mwezi2k8/JetSetGo-/README- jsg.md

# JetSetGO! - A RC high wing, bi-propellor trainer plane

Total time spent : 13+ hours



---

### JOURNAL #1 BUILDING MY FIRST RC AIRCRAFT!
Time spent : 1 hour 20 minutes

Deciding the basic design.
From a long time, I was fascinated by seeing rc trainers online, so I wanted to build one and I decided why not for expedition!
So I went off researching about different aircrafts for beginners, mostly YouTube and internet surfing
Since this was my first aircraft, the most beginner friendly one I found is a standard high wing rc trainer.
But I was not satisfied by that so after some more research and going through different innovative designs, I decided to build a bi-propellor.



This was my inspiration which I found on the internet.

---

### JOURNAL #2 Research and concept
Time spent : 1 hour for wings, 2 hours 15 minutes for tail, fuselage, nose) 3 hours 15 minutes

The concept is a twin-motor high-wing trainer, next was researching for wings, tails, fins e.t.c
After going through random YouTube videos and some websites, what I finalised was -

A. Wings- Armin folded wing with two counter-rotating motors in pods under the wing.



B. TAIL AND FINS - inspired from my childhood favourite V22 Osprey style H tail



C.NOSE - a square-pyramid nose, since there is no motor on the nose, a simple square pyramid nose does the job!

D.FUSELAGE - I was tired researching for wings, tail and nose so I decided to go on with a simple back tapered fuselage

---

### JOURNAL #3 Studying basics of aerodynamics
Time spent : 2 hour 10 minutes

While surfing through internet for finalising the designs and completing the concept, I realised that I can't randomly attach any part anywhere as I wish, everything needs to be planned to make it aerodynamically more efficient.
Carelessly if I make one side of the wing slightly heavy or shift the CG, the game is over!
This also sparked an interest in me which made me study basics of aerodynamics and making a rc trainer
I studied about 2 hours 10 minutes , which I will try my best to further summarise below so someone with zero experience in aviation could understand the basics and reciprocate, also from this point I will be directly using those terminology

3.1) forces on an airplane -



The negative forces are the drag and the weight, plane counters it by Thrust for Drag and lift for weight

3.2) Airfoil and lift generation-
How is the lift generated? Something special about the wings?

Airfoil -



The cross section of the wing and its peculiar shape is in order to generate lift
Aerodynamic characteristics vary greatly with airfoil shape

Lift generation-



Due to the peculiar shape of the airfoil, a curvature is induced in the incoming airflow. Due to the asymmetry in this curvature on the top and bottom parts of the wing, a net upward lift is generated.

Some more physics, the lift equation

L = Cl x (1/2 x ρ x v²) x A

L = lift (N), Cl = coefficient of lift, ρ = density (kg/m³), v = velocity (m/s), A = wing area (m²)

---

### JOURNAL #4 Anatomy of the plane
Time spent : 2 hours

4.1) The parts -



4.2) Aircraft principal axis -



So how the movement in each axes controlled?

~roll motion due to the movement of ailerons  
~Yaw motion due to the movement of rudder  
~pitch motion due to the movement of elevator

4.3) Centre of gravity-
The point at which the torque and force are balanced is the Centre of Gravity
It should lie either at or ahead of 1/4 of the chord length of the wing for neutral or positive stability, respectively.



High wing provides the roll stability!

4.4) Aspect ratio -



Higher AR → Better performance, better stability, but also leads to wing bending.

Lower AR → Great for structure, better maneuverability, but increases drag.

---

### Journal #5 Planning the power
Time spent : 45 minutes

Considering the parts I already had the electronics I finalised are as follows;
Two 1400 kV motors with 7×4 props, one normal and one reversed, spinning opposite ways so their torque cancels.
Two 30 A ESCs on one throttle channel through a Y-lead, with the red wire removed from one ESC's plug which prevents two internal Battery Eliminator Circuits (BECs) from fighting each other and potentially damaging the electronics.
One 3S battery feeding both ESCs through a parallel lead.

---

### Journal #6 material preperation
Time spent : 50 minutes

I am adding a list of materials required, I had most of them, rest were borrowed from my friends garage

- 2 Depron sheets, 100 × 65 cm (about 3 mm thick)
- Packing tape (to tape the sheets), electrical tape (hinges), duct tape (nose and belly only)
- 6 mm carbon rod, 100 cm
- 2 × 1400 kV brushless motors with X-mounts and prop adapters
- 7×4 props, one normal and one reversed ("R"), plus spares of each
- 2 × 30 A ESCs, a parallel battery lead, a 3S 1300 mAh LiPo and charger
- Transmitter and receiver (4 channels or more), 2 servo Y-leads
- 3 × 9 g servos with arms, 3 control horns
- About 60 cm of 1 mm steel wire (pushrods) and 30 cm of 2 mm steel wire (landing gear)
- 2 × 50 mm wheels with collars
- 3 mm plywood scraps (2 motor plates, 1 gear plate), M3 bolts and nuts
- Bamboo skewers, 4 rubber bands, velcro, small zip ties, popsicle sticks
- Low-temperature hot glue sticks

Tools
Snap-off cutter with fresh blades, 100 cm steel ruler, set square, pencil, cutting mat, low-temperature glue gun, 120 and 240 sandpaper, pliers, wire cutter, vice, drill (3, 8 and 10 mm), kitchen scale, a few heavy books.

---

### Journal #7 Design Calculations
Time spent : 2 Hours 40 minutes

I had depron sheet of 65*100cm, and a one-piece wing avoids a weak joint, so I fixed the span of 100cm
So to pick the wing area from the weight, estimate the all up weight and divide by the wing loading.
I approximated the weight as follows;

| Part | Weight (g) |
| --- | --- |
| 2 motors | 100 |
| 2 ESCs | 60 |
| 3S 1300 mAh battery | 110 |
| 3 servos | 30 |
| Receiver, wiring, Y-leads | 50 |
| Pods and motor plates | 40 |
| Wing (folded, taped) | 165 |
| 6 mm carbon rod | 22 |
| Fuselage and nose | 100 |
| Tail and fins | 30 |
| Landing gear | 30 |
| Pushrods, horns, glue, tape | 65 |
| Total | ≈ 800 |

Following the 40 g/dm² trainer wing loading we get the wing area as

S = W / 40 = 800 / 40 = 20 dm²  
c = S / b = 2000 cm² / 100 cm = 20 cm

Hence the aspect ratio is

AR = b / c = 100 / 20 = 5

The extra thrust from the bi propellor compensates for a little lower aspect ratio
Then I splitted the chord length of 20cm into 15cm + 5 cm for ailerons
The fuselage should be about 0.8 of wingspan so we get a fuselage length of 80 cm
This concludes all the major dimensions I need, the calculations took my patience to its limit but were indeed one of the most important part of this build
This really sets up how smooth a plane fliesss!

---

### JOURNAL #8 Drawing the sketch
Time spent :

After getting the major dimensions, many rough tries and some wasted sheet of paper, the sketch I finalised is as follows
(Ps: I suck at drawing but I still have that thing were I draw again and again till I like the sketch)



So this was one of my first design, the next ones are improved and drawn after making the calculations

---

### JOURNAL #9 Taping, Drawing the parts
Time spent :

The first step is to tape the depron from 1 side, it's a ritual you do before starting! Jokes apart, it helps in cutting the parts without breaking/cracking the depron

I used 2 65*100cm depron sheets





Also note that the direction of taping is important as well
