mwezi2k8/JetSetGo-/jsg-CAD.step

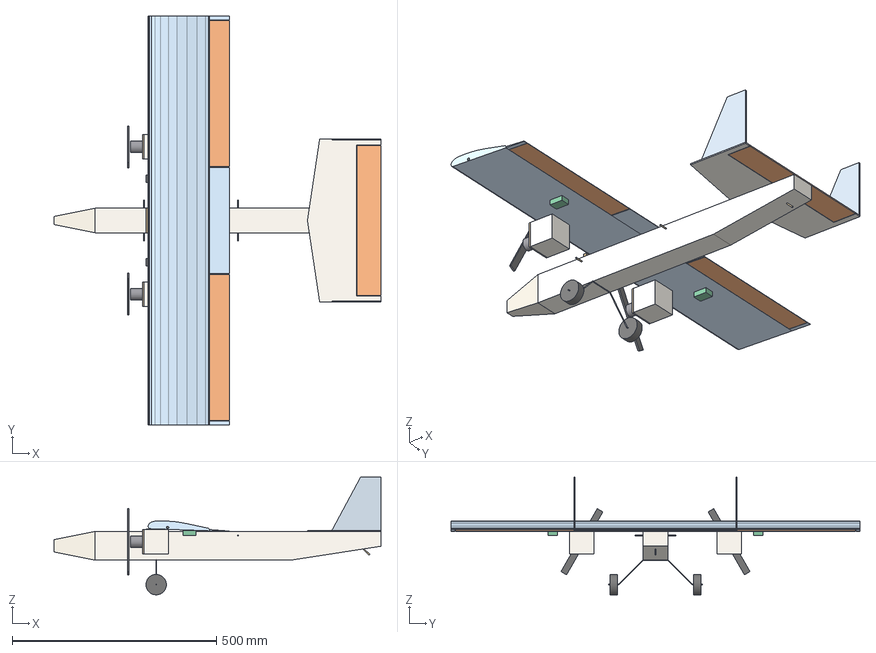
[picture p1: CAD file, 2026-10-29]
jsg-CAD.step
800.0 x 1000.0 x 288.0 mm
